ole00/hardware_mister_de0-nano-soc/addons/io_board/v02_render.png

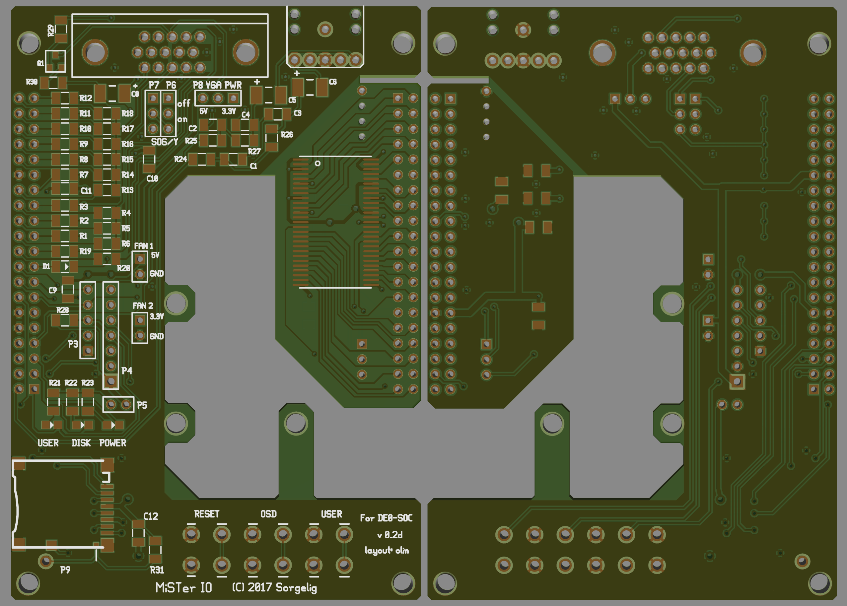
addons/io_board/v02_render.png
