ole00/hardware_mister_de0-nano-soc/(list of files, drawings)

Other design files:
addons/io_board/de0_io_board.pcb
