ole00/hardware_mister_de0-nano-soc/(commit log)

2017-11-29 created addons directory with the de0_io_board design
    [de0_io_board.pcb]
2017-12-01 version 0.2b
    Fixed:
    - ground connection on VGA pins
    - ground connection on microsd connector pads
    - ground connection on P1-10 pin
    - moved Fan mounting holes upwards because previously
    the bottom left wan was blocked by the Ethernet connector
    [de0_io_board.pcb]
2017-12-09 Version 0.2c
    - changed footprint of C5, C6, C8 to have more space between pads (safer reflow)
    - added missing C9, C10, C11
    - fixed mounting hints for buttons on silk screen
    - added VGA shield grounding on big mounting holes
    - moved SDRAM Arduino pins 0.125mm down to match Terasic specs for DE0-nano-Soc
    [de0_io_board.pcb]
2018-01-14 Version 0.2d
    - added Fan2 connector for 3.3V
    - added VGA shield grounding on bottom of big mounting holes
    - added non-plated holes to the top 3 Arduino pins for future
    use. Also added a plated hole connected to ground to support
    Arduino pins.
    [de0_io_board.pcb]
2018-01-28 Modified README.md
    Changed status from Work-In-Progress to Beta.
    Added information about PCB production parameters.
2018-01-28 added gerber zip archive for version 0.2d
2018-01-28 added BOM for the IO board
2018-01-30 fixed BOM
    added tactile switch info
    fixed diode part number
2018-01-30 added board stencil in svg format
2018-01-30 added schematic info and link
